justarandomgeek/NerfPWM/NerfPWM V1.1.brd

## EAGLE design NerfPWM V1.1.brd (2013-09-28, an earlier design)

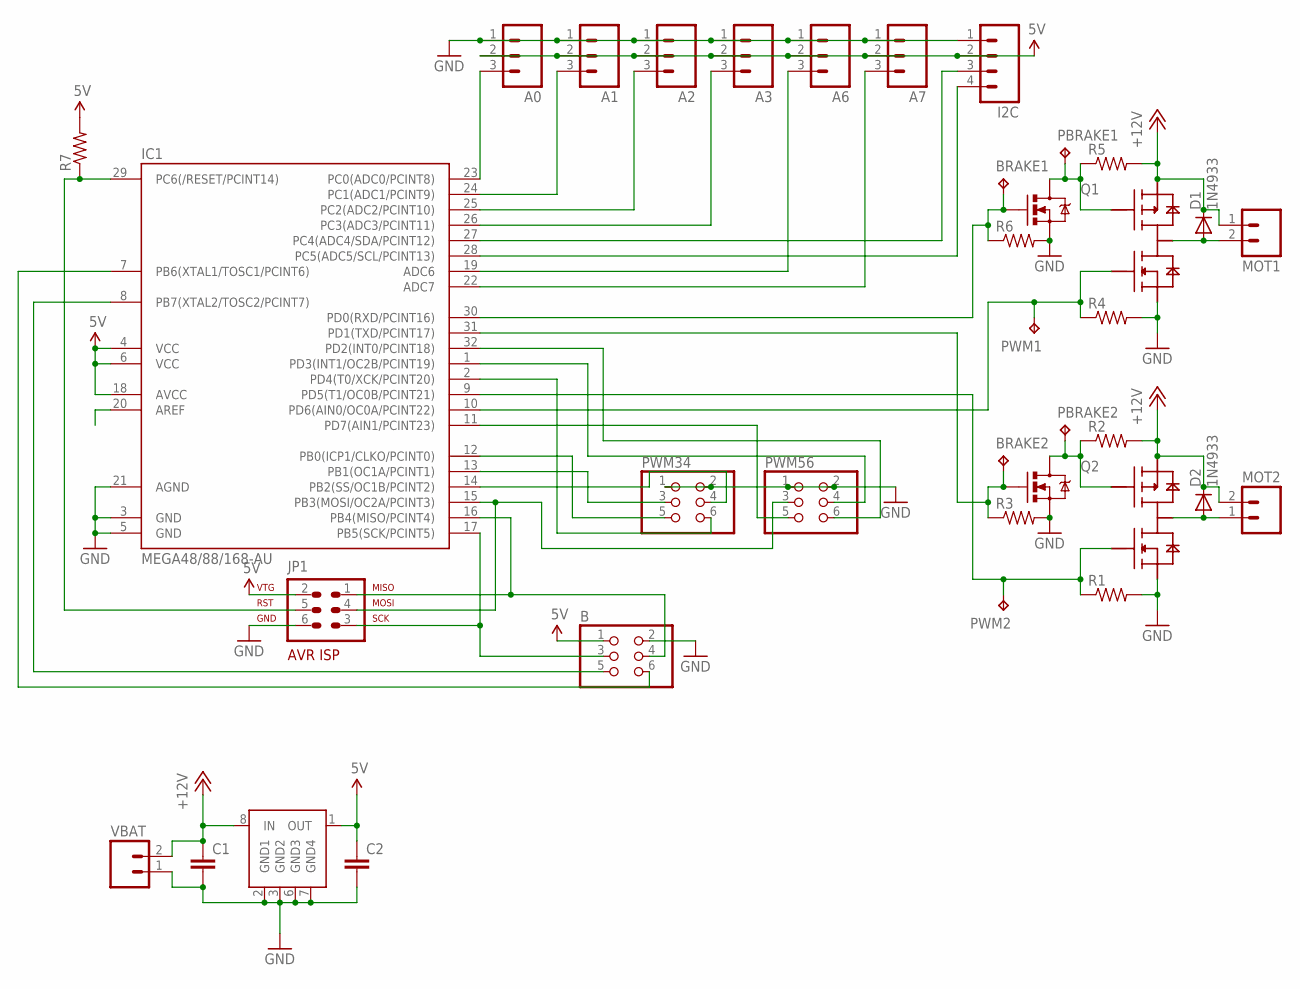
[picture p1: schematic NerfPWM V1.1.sch]

Parts:
A0, A1, A2, A3, A6, A7: M03PTH; 1X03
B: PINHD-2X3; 2X03
BRAKE1, BRAKE2: TPTP10R; TP10R
C1, C2: CAP1206; 1206
D1, D2: 1N4933; DO41-10
I2C: M04PTH; 1X04
IC1: MEGA48/88/168-AU; TQFP32-08
JP1: AVR-ISP-6
MOT1, MOT2: M023.5MM_LOCK; SCREWTERMINAL-3.5MM-2_LOCK
PBRAKE1, PBRAKE2: TPTP10R; TP10R
PWM1, PWM2: TPTP10R; TP10R
PWM34, PWM56: PINHD-2X3; 2X03
Q1, Q2: MOSFET-NCHANNELSMD; SOT23-3
R1, R2, R3, R4, R5, R6, R7: RESISTOR; 0805
U$3: MC78L00AD; SOIC8
U$4, U$5: SI4501BDY; SOIC8
VBAT: M023.5MM_LOCK; SCREWTERMINAL-3.5MM-2_LOCK

Connections:
5V: A0.2, A1.2, A2.2, A3.2, A6.2, A7.2, B.1, C2.1, I2C.2, IC1.4 (VCC), IC1.6 (VCC), IC1.18 (AVCC), JP1.2, R7.2, U$3.1 (OUT)
+12V: C1.1, D1.C, D2.C, MOT1.1, MOT2.2, R2.2, R5.2, U$3.8 (IN), U$4.3 (S2), U$5.3 (S2), VBAT.2
A1: A1.3, IC1.24 (PC1(ADC1/PCINT9))
A2: A2.3, IC1.25 (PC2(ADC2/PCINT10))
A3: A3.3, IC1.26 (PC3(ADC3/PCINT11))
A6: A6.3, IC1.19 (ADC6)
A7: A7.3, IC1.22 (ADC7)
A): A0.3, IC1.23 (PC0(ADC0/PCINT8))
B4: B.4, IC1.16 (PB4(MISO/PCINT4)), JP1.1
B5: B.3, IC1.17 (PB5(SCK/PCINT5)), JP1.3
B6: B.6, IC1.7 (PB6(XTAL1/TOSC1/PCINT6))
B7: B.5, IC1.8 (PB7(XTAL2/TOSC2/PCINT7))
BRAKE1: BRAKE1.TP, IC1.30 (PD0(RXD/PCINT16)), Q1.1 (G), R6.1
BRAKE2: BRAKE2.TP, IC1.31 (PD1(TXD/PCINT17)), Q2.1 (G), R3.1
BRAKE3: IC1.12 (PB0(ICP1/CLKO/PCINT0)), PWM34.5
BRAKE4: IC1.2 (PD4(T0/XCK/PCINT20)), PWM34.6
BRAKE5: IC1.11 (PD7(AIN1/PCINT23)), PWM56.5
BRAKE6: IC1.32 (PD2(INT0/PCINT18)), PWM56.6
GND: A0.1, A1.1, A2.1, A3.1, A6.1, A7.1, B.2, C1.2, C2.2, I2C.1, IC1.3 (GND), IC1.5 (GND), IC1.21 (AGND), JP1.6, PWM34.1, PWM34.2, PWM56.1, PWM56.2, Q1.2 (S), Q2.2 (S), R1.2, R3.2, R4.2, R6.2, U$3.2 (GND1), U$3.3 (GND2), U$3.6 (GND3), U$3.7 (GND4), U$4.1 (S1), U$5.1 (S1), VBAT.1
unnamed: PBRAKE2.TP, Q2.3 (D), R2.1, U$5.4 (G2)
unnamed: PBRAKE1.TP, Q1.3 (D), R5.1, U$4.4 (G2)
PWM1: IC1.10 (PD6(AIN0/OC0A/PCINT22)), PWM1.TP, R4.1, U$4.2 (G1)
PWM2: IC1.9 (PD5(T1/OC0B/PCINT21)), PWM2.TP, R1.1, U$5.2 (G1)
PWM3: IC1.13 (PB1(OC1A/PCINT1)), PWM34.3
PWM4: IC1.14 (PB2(SS/OC1B/PCINT2)), PWM34.4
PWM5: IC1.15 (PB3(MOSI/OC2A/PCINT3)), JP1.4, PWM56.3
PWM6: IC1.1 (PD3(INT1/OC2B/PCINT19)), PWM56.4
RESET: IC1.29 (PC6(/RESET/PCINT14)), JP1.5, R7.1
SCL: I2C.4, IC1.28 (PC5(ADC5/SCL/PCINT13))
SDA: I2C.3, IC1.27 (PC4(ADC4/SDA/PCINT12))
VMOT1: D1.A, MOT1.2, U$4.5 (D), U$4.6 (D), U$4.7 (D), U$4.8 (D)
VMOT2: D2.A, MOT2.1, U$5.5 (D), U$5.6 (D), U$5.7 (D), U$5.8 (D)

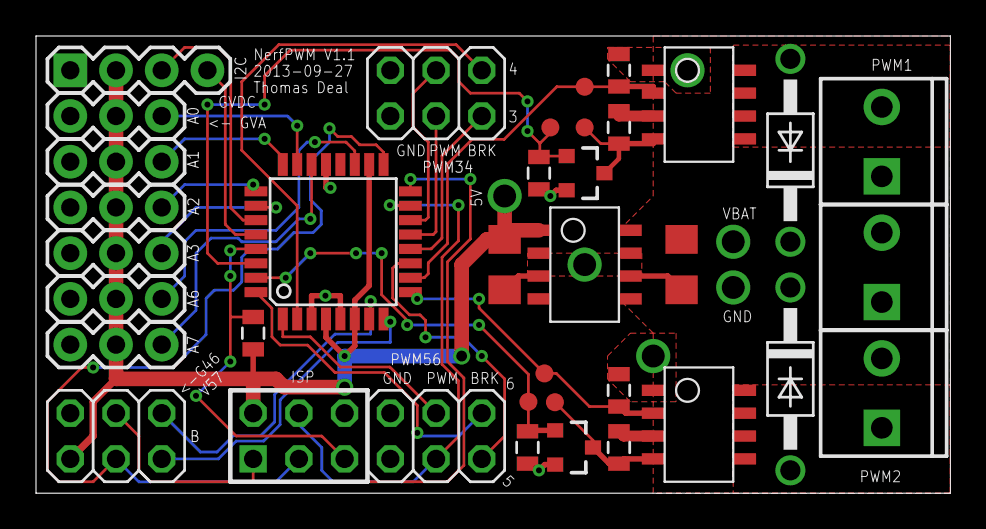
[picture p2: board NerfPWM V1.1.brd from above]

Board: 2 copper layers, 50.8 x 25.4 mm, 37 parts (0 on the bottom side), 32 nets.
