justarandomgeek/NerfPWM/code/main.c

/* ========================================================================== */
/*                                                                            */
/*   main.c                                                                   */
/*   (c) 2011 Thomas Deal                                                     */
/*                                                                            */
/*   Description                                                              */
/*                                                                            */
/* ========================================================================== */

#include <avr/power.h>
#include "nerfpwm.h"
#include "mixer.h"
#include "adc.h"
#include "pwm.h"

/*

tasks:

* read adc - in adc.c	
* I2C add-ons
* 	-ISR: receive packets, send packet, set flag (or callback?) on receive (or complete?)
* 	-flags:
* 	-data: 
* 		-out: malloc'd packets
* 		-in: myaddr:7|X:1

ISRs:

INT0_vect			# pin shared with BRAKE6 #
INT1_vect			# pin shared with PWM6 #
PCINT0_vect		# bits 4-7 may be usable / GPIO_B #
PCINT1_vect		# bits 0-3 usable if not used for analog in  #
PCINT2_vect		# some pins usable if not used for PWM/BRAKE #
WDT_vect			unused ? maybe use for threading ?
TIMER2_COMPA_vect	unused # timing forced for hardware PWM for PWM5 if used #
TIMER2_COMPB_vect	unused # timing forced for hardware PWM for PWM6 if used #
TIMER2_OVF_vect	unused # timing forced for hardware PWM for PWM5/6 if used #
TIMER1_CAPT_vect	unused # timing range forced by PWM for PWM3/4 if used #
TIMER1_COMPA_vect	unused # timing forced for hardware PWM for PWM3 if used #
TIMER1_COMPB_vect	unused # timing forced for hardware PWM for PWM4 if used #
TIMER1_OVF_vect	unused # timing forced for hardware PWM for PWM3/4 if used #
TIMER0_COMPA_vect   unused # timing forced for hardware PWM for PWM1 #
TIMER0_COMPB_vect	unused # timing forced for hardware PWM for PWM2 #
TIMER0_OVF_vect	unused # timing forced for hardware PWM for PWM1/2 #
SPI_STC_vect		# pins used by PWM4/5, GPIO #
USART_RX_vect		# pins used as BRAKE1/2 #
USART_URDE_vect	# pins used as BRAKE1/2 #
USART_TX_vect		# pins used as BRAKE1/2 #
ADC_vect			used for reading inputs
EE_READY_vect		unused
ANALOG_COMP_vect	# not usable, pins are used for PWM1/BRAKE5 #
TWI_vect			used for packet net of peripherals
SPM_REDY_vect		unused
*/

#include <util/delay.h>

int main(void)
{
	// in case CLK_DIV_8 is programmed
	clock_prescale_set(clock_div_1);
	
	settings_init();
	
	//init_twi();
	
	adc_init();
	pwm_init();
		
	
	sei();
		
	
	while(1){
		if(adc_new_data)
		{
			adc_new_data=0;
			
			// calculate new mix values.
			for(int i=0;i<MAX_MIXERS;i++) apply_mix(&settings.mixData[i]);
		
			// copy output values from mixOuts to appropriate places...
			pwm_write(&mixOuts[OUT_PWM1]);	
			
			// update previous values for edge detectors
			for(int i=0;i<MAX_EDGES;i++) edgePrev[i] = read_digital(settings.edgeData[i]);
 								
			_delay_ms(5);	
		}
		
	}
}
