justarandomgeek/NerfPWM/(commit log)

2013-07-13 Import existing Schematic/Board files.
    [NerfPWM.brd, NerfPWM.sch]
2013-07-28 Changed ISP header.
    [NerfPWM.brd, NerfPWM.sch]
2013-08-01 Increased spacing between high-power traces/pours. Enabled thermals for vias (specifically, for the large vias providing power/ground for hacking).
    [NerfPWM.brd, NerfPWM.sch]
2013-08-02 Increased text size to improve silkscreen readability, and rearranged as needed to fit. Changed version number/date to unspecified until next tagged release.
    [NerfPWM.brd]
2013-08-04 Increased spacing around FET ground connections.
    [NerfPWM.brd, NerfPWM.sch]
2013-08-04 Changed PWM 1/2 writing to a macro. This will make it easier to apply the same code for PWMs 3-6.
    Converted mix source/dest/multiplex values to be enum types.
2013-08-04 enum for switches (logic, to be renamed soon...) clean up macros from last commit a little.
2013-08-19 Makefile: MCU switched to 328 for prototype boards. Also added targets flash/eeprom, and configured debug/programmer options adc.c: adc_val is now volatile. Also, cleaned up some of the init/ISR code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
    main.c: added initializer and macro for default eeprom settings. Removed clock speed config options, this will only run from on-chip 8MHz for now. Now reads eeprom settings into ram. Various bugfixes in main loop.
    [adc.c, main.c, mixer.c]
2013-08-25 move settings to a seperate header. ADC now configures pins based on settings. PWM configures pins on the pwm34 header.
2013-09-08 Added support for constants in mixer. Use Offset as constant value, when added it will wrap correctly. Added settings configuration for my RapidStrike with first prototype board installed.
    [mixer.c, settings.c, settings.h]
2013-09-09 Some minor changes to PWM module. Braking still does not work as expected. Changes to settings config for my RS.
    [pwm.c, settings.c]
2013-09-28 Silkscreen tag Mainboard V1.1 for ordering new boards.
    [NerfPWM.brd]
2013-10-20 Board revisions for easier assembly of next batch.
    [NerfPWM.brd]
2014-01-18 Makefile switched to atmega168 default, for more recent boards. Added profile for Stryfe.
2014-01-18 main.c: Added a 10ms delay after updating mixes. This reduces glitches in fast-changing outputs. mixer.h: corrected numbering is comment. pwm.c: correctly turn off PWM pin when value is 0.
    [main.c, mixer.h, pwm.c]
2014-02-11 Mixer updates to add Edge Detectors, and other minor changes.
    * Add edge-detectors as switch types.
    * mixOuts is now sized by NUM_MIXOUTS, which is the last value in the enum.
    * Named vars OUT_VAR1-4.
2016-01-22 Add default safe settings if no PROFILE is set. Tweak RAPIDSTRIKE PWM levels.
2017-03-30 Old uncommitted changes
    [NerfPWM V1.1.brd, NerfPWM V1.1.sch]
